iwanders/focus_stacking/doc/software/state_diagram.pdf

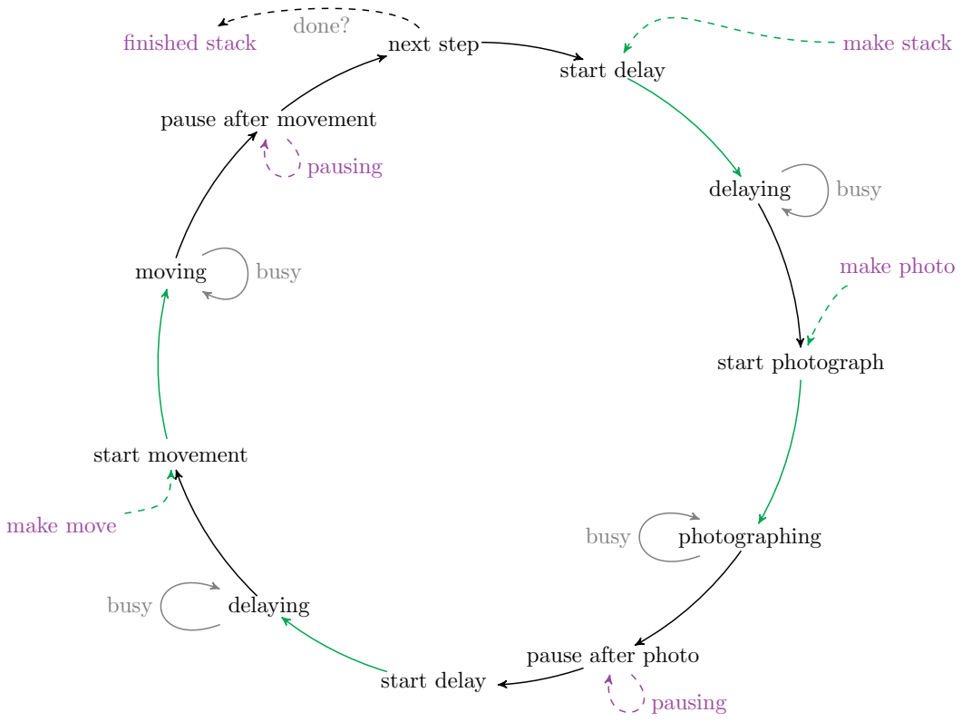
[picture p5: figure]
start delay; delaying; start photograph; photographing; pause after photo; start movement; moving; pause after movement; next step; make stack; make photo; make move; finished stack; done?; busy; pausing
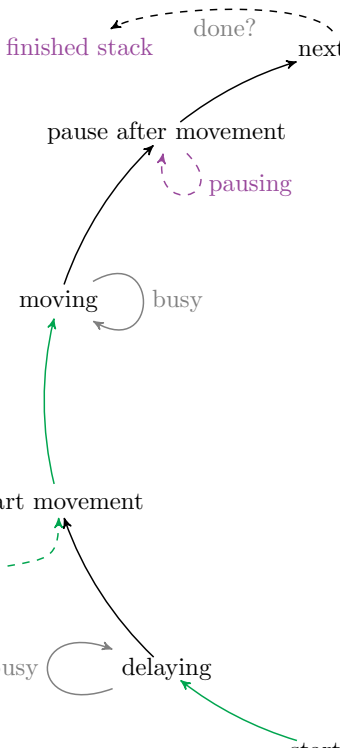
[picture p6: figure]
