iwanders/focus_stacking/doc/photo/hardware_setup.jpg

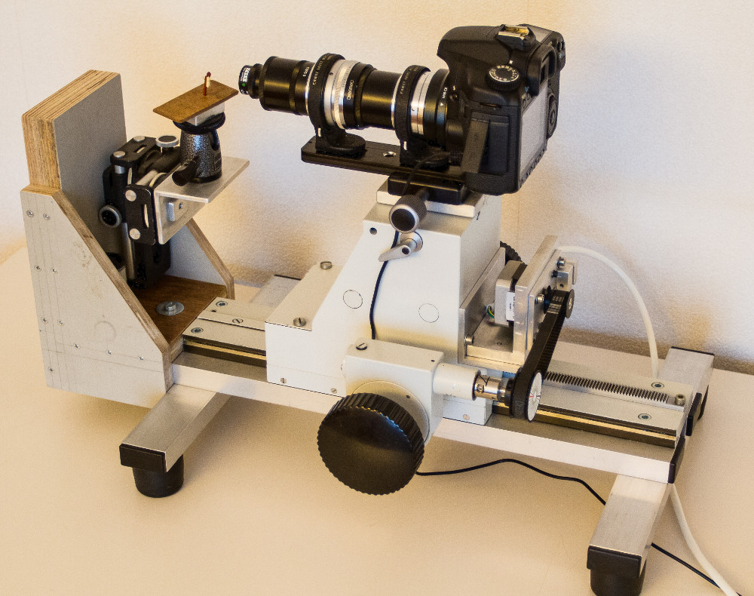
doc/photo/hardware_setup.jpg
