iwanders/focus_stacking/doc/schematic/focus_stacking_schematic.pdf

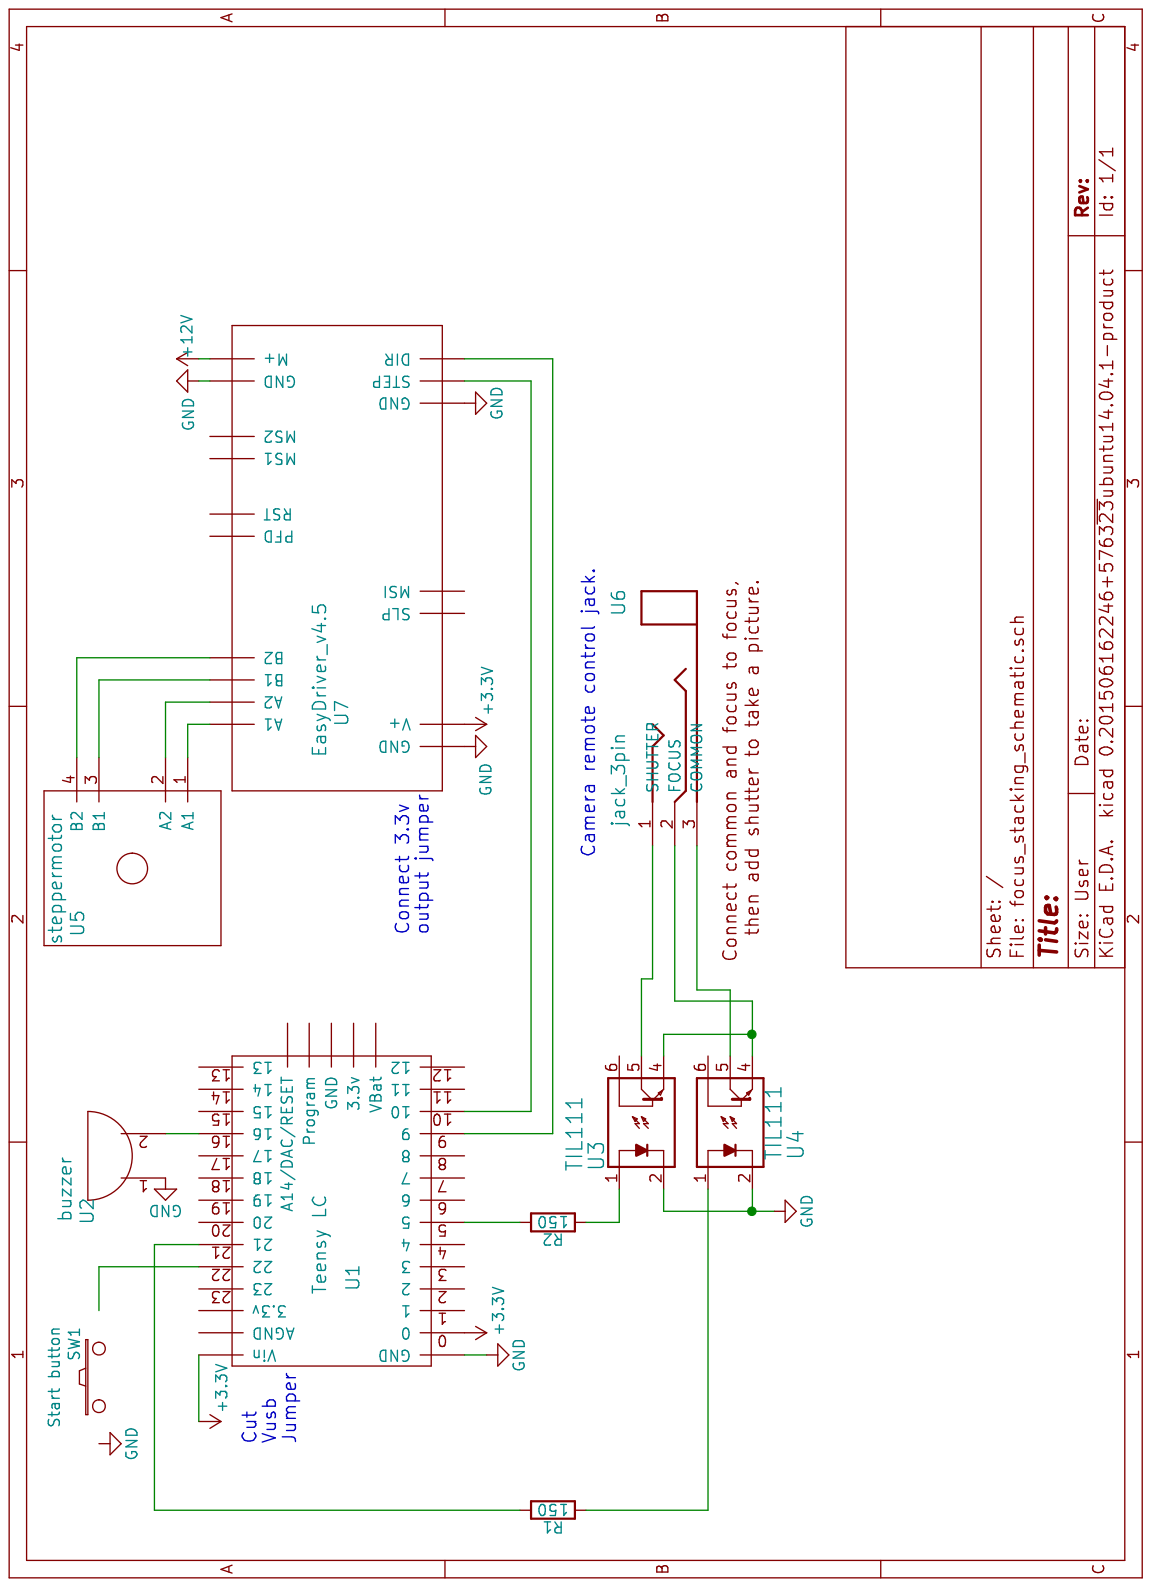
[picture p8: page 1]
