iwanders/focus_stacking/doc/schematic/focus_stacking_schematic.sch

## KiCad design doc/schematic/focus_stacking_schematic.sch (2016-04-24)

Schematic: focus_stacking_schematic.sch

Parts:
R1, R2: 150
SW1: Start button
U1: Teensy LC
U2: buzzer
U3, U4: TIL111
U5: steppermotor
U6: jack_3pin
U7: EasyDriver_v4.5

Notes on the sheet:
Cut Vusb Jumper
Camera remote control jack.
Connect 3.3v output jumper
