iwanders/focus_stacking/firmware/stack_interface.cpp

/*
  The MIT License (MIT)

  Copyright (c) 2016 Ivor Wanders

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
  THE SOFTWARE IS PROVIDED "AS IS", WITHOUT WARRANTY OF ANY KIND, EXPRESS OR
  IMPLIED, INCLUDING BUT NOT LIMITED TO THE WARRANTIES OF MERCHANTABILITY,
  FITNESS FOR A PARTICULAR PURPOSE AND NONINFRINGEMENT. IN NO EVENT SHALL THE
  AUTHORS OR COPYRIGHT HOLDERS BE LIABLE FOR ANY CLAIM, DAMAGES OR OTHER
  LIABILITY, WHETHER IN AN ACTION OF CONTRACT, TORT OR OTHERWISE, ARISING FROM,
  OUT OF OR IN CONNECTION WITH THE SOFTWARE OR THE USE OR OTHER DEALINGS IN THE
  SOFTWARE.
*/
#include "./stack_interface.h"


void StackInterface::run() {
  // check if we need to send the status
  if (duration_ > status_interval_) {
    duration_ = 0;
    sendStatus();
  }

  // check if we should read the serial port
  if (Serial.available()) {
    char buffer[sizeof(msg_t)] = {0};
    if (Serial.readBytes(buffer, sizeof(msg_t)) == sizeof(msg_t)) {
      // we have a command, process it.
      processCommand(reinterpret_cast<msg_t*>(buffer));
    }
  }

  // check if we need to start with the start button.
  if (digitalRead(start_stack_pin_) == LOW) {
    setConfigs();
    if ((stack_->isIdle())) {
      stack_->stack();
      busy_stacking_ = true;
    }
  }
  if (busy_stacking_ && stack_->isStackFinished()) {
    busy_stacking_ = false;
    if (buzzer_duration_ != 0) {
      tone(buzzer_pin_, buzzer_frequency_, buzzer_duration_);
    }
  }
}

void StackInterface::sendStatus() {
  // assemble the status update...
  char buffer[sizeof(msg_t)] = {0};
  msg_t* response = reinterpret_cast<msg_t*>(buffer);
  response->type = get_status;
  response->status.motor = motor_->getStatus();
  response->status.stack = stack_->getStatus();
  response->status.camera = camera_->getStatus();
  // send it.
  Serial.write(buffer, sizeof(msg_t));
}

void StackInterface::retrieveConfigs() {
  config_motor_ = motor_->getConfig();
  config_camera_ = camera_->getConfig();
  config_stack_ = stack_->getConfig();
}

void StackInterface::setConfigs() {
  motor_->setConfig(config_motor_);
  camera_->setConfig(config_camera_);
  stack_->setConfig(config_stack_);
}


void StackInterface::processCommand(const msg_t* msg) {
  switch (msg->type) {
    case nop:
      SIDBGln("Got nop.");
      break;

    case set_config:
      SIDBGln("Got set_config.");

      // store these configs for later use
      config_motor_ = msg->config.motor;
      config_camera_ = msg->config.camera;
      config_stack_ = msg->config.stack;

      // also set them.
      setConfigs();

      this->setConfig(msg->config.interface);
      break;

    case get_config: {
        SIDBGln("Got get_config.");
        char buffer[sizeof(msg_t)] = {0};
        msg_t* response = reinterpret_cast<msg_t*>(buffer);
        response->type = get_config;

        // retrieve the configs.
        response->config.motor = config_motor_;
        response->config.camera = config_camera_;
        response->config.stack = config_stack_;
        response->config.interface = this->getConfig();
        SIDBGln(response->config.motor.min_width);
        Serial.write(buffer, sizeof(msg_t));
      }
      break;

    case action_motor:
        // move the motor if it is not moving already and we are not stacking.
        if ((stack_->isIdle())) {
          stack_->move(msg->action_motor.steps);
        }
      break;

    case action_stack:
        setConfigs();
        if ((stack_->isIdle())) {
          stack_->stack();
          busy_stacking_ = true;
        }
      break;

    case action_camera:
        if ((stack_->isIdle())) {
          stack_->photo();
        }
      break;

    case action_stop:
        stack_->stop();
        noTone(buzzer_pin_);
        busy_stacking_ = false;
      break;

    case get_version: {
        char buffer[sizeof(msg_t)] = {0};
        msg_t* response = reinterpret_cast<msg_t*>(buffer);
        response->type = get_version;
        response->version.unstaged = VERSION_WORKING_DIRECTORY_CHANGES_UNSTAGED;
        response->version.staged = VERSION_WORKING_DIRECTORY_CHANGES_STAGED;
        uint8_t hash[] = make_xstr(VERSION_GIT_HASH);
        memcpy(&(response->version.hash), hash, sizeof(response->version.hash));
        Serial.write(buffer, sizeof(msg_t));
      }
      break;

    case get_status: {
        sendStatus();
      }
      break;

    default:
      SIDBGln("Got unknown command.");
  }
}
