iwanders/focus_stacking/(commit log)

2016-02-25 Initial commit.
    Some testing of the preliminary stepper controller class.
2016-02-25 Separate the motor stepper code into separate files.
    Ready to be used with the motor_control class or something like that.
2016-02-26 Documentation and cleanup for the MotorStepper class.
2016-03-09 Improves the begin method of the MotorStepper.
    Set the pin modes and start the timer, this makes it more intuitive.
2016-03-15 Separates the IntervalTimer code from the MotorStepper.
    Now uses a single class which can deal with multiple stepper motors in the
    background, but not depends on this by default.
2016-03-15 Adds CameraControl class for making photos.
2016-03-20 Abstracts the motor and camera controls.
    Should make it easier to use another motor controller in the future.
2016-03-20 Prevents incorrect camera state due to race condition.
    Needed a boolean to check whether the photo is finished, otherwise the pins
    might not be set to low.
    [camera_control.cpp, camera_control.h]
2016-03-20 Prevents movement after the last photo.
    Fixes that silly behaviour when the camera moves after the last photo has
    been made.
    [main.cpp, stack_control.cpp, stack_control.h]
2016-03-25 Improves the stack interface.
    Adds a start command and fixes a bug in returning the config.
    [main.cpp, message.py, stack_interface.cpp, stack_interface.h]
2016-03-27 Adds photo and camera actions.
    Including the messages and commandline commands.
2016-04-02 Fixes the setting and getting of the config.
    Returned the wrong values by mistake.
    [stack_interface.cpp]
2016-04-03 Fixes scoping of javascript method calls.
    Not sure if this is the correct way of using Javascript objects, but it works.
    [interface.py, server.py]
2016-04-03 Adds a get_version command.
    Returns the version of the firmware currently in use.
    Actually it returns the last git commit and two flags indicating whether the
    working direction war clean.
2016-04-03 Adds handling for list types to convert arrays.
    The Dictionary mixin failed on the newly introduced hash.
    [message.py]
2016-04-03 Retrieves version after serial connection.
    This provides feedback if the serial port that was selected is the wrong one.
    [interface.py, message.py, server.py]
2016-04-09 Changes the MCU target.
    Now uses a Teensy LC.
2016-04-09 Fixes a bug when the ramp_length exceeded step_goal.
    Caused the ramp down to be skipped.
    [motor_stepper.cpp]
2016-04-09 Improves the settings pane.
    Adds functionality for camera and transmission ratio.
2016-04-09 Fixes incorrect state transition.
    [stack_control.cpp]
2016-04-10 Adds start and stop buttons.
    And the ui for the status.
2016-04-10 Adds an external button to start the stacking.
2016-04-24 Add electrical schematic for the project.
    Also moves the state diagram into a separate directory.
    [focus_stacking_schematic.sch]
2016-04-25 Clarify readme and fix typos.
    Fixes a few typos and clarifies a few lines. Also moves the MotorStepper
    paragraph down a bit so that the explanation doesn't start with that.
2016-05-08 Removes upload buttons.
    Now automatically upload in all situations.
2016-05-08 Add method to delete preset and UI improvements.
    Now allows removal and correctly displays empty lists and preset information.
    [server.py]
2016-05-08 Add buzzer functionality.
    The buzzer can be used to create an audible notification when the stacking
    sequence is finished. It can be disabled by setthing the duration to zero.
    [config.h, main.cpp, message.py, stack_control.h, stack_interface.cpp, stack_interface.h]
2016-05-08 Prevent beep at startup.
    A beep was present at the start because isStackFinished() returned true.
    [main.cpp]
2016-06-26 Prevent crash when writing to unopened port.
    If the serial port was still unset this could cause an error if the Tx queue
    was already being processed.
    [interface.py]
2016-07-03 Changes to improve performance under OS X.
    Newest version of teensy core, decreases update interval.
2017-01-29 Adds a note about the transmission ratio.
    Use a newer version of Teensyduino.
